bazolting71-arch/Drone-Payload-Hook-V2/docs/images/box_v23_hm10.png

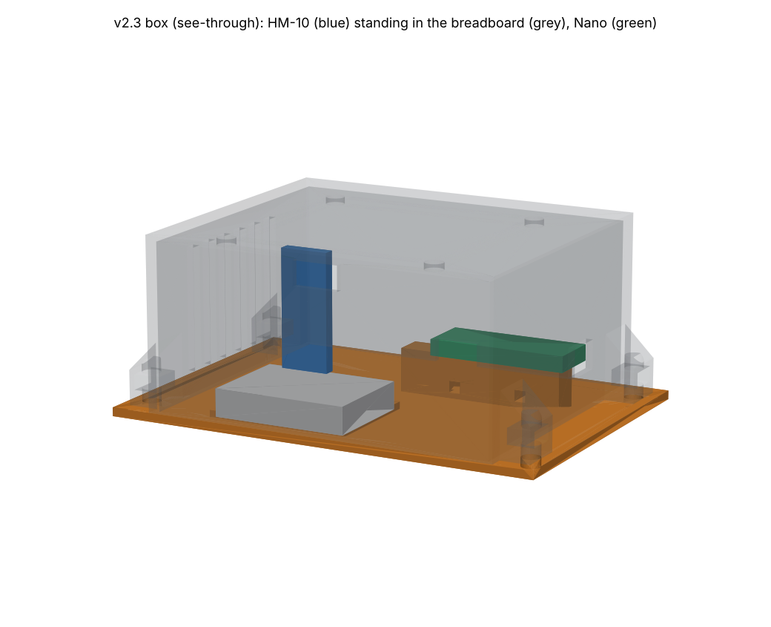
docs/images/box_v23_hm10.png
