bazolting71-arch/Drone-Payload-Hook-V2/docs/images/hook_rod_before_after.png

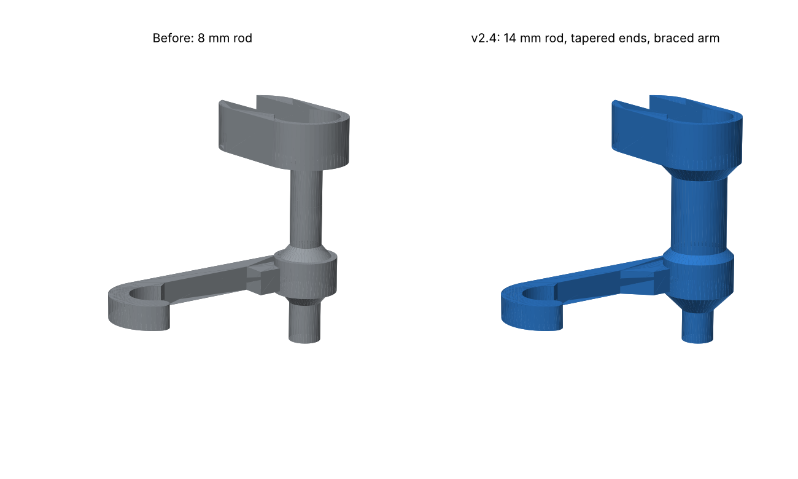
docs/images/hook_rod_before_after.png
