bazolting71-arch/Drone-Payload-Hook-V2/docs/images/servo_fasteners_v22.png

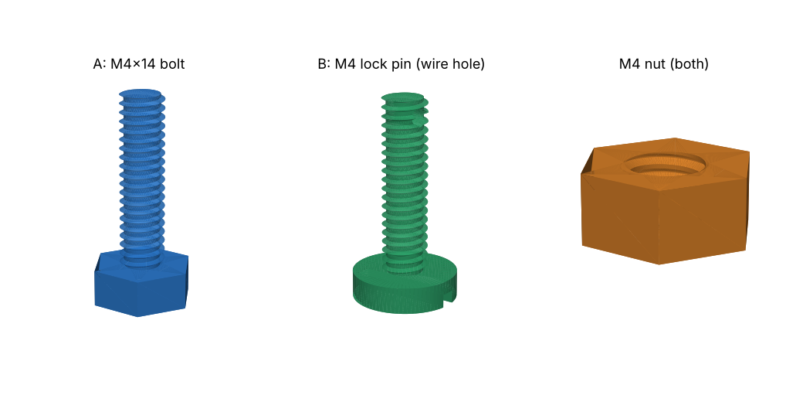
docs/images/servo_fasteners_v22.png
