bazolting71-arch/Drone-Payload-Hook-V2/cad/Thingy_Hook_Mount_v2.5.step

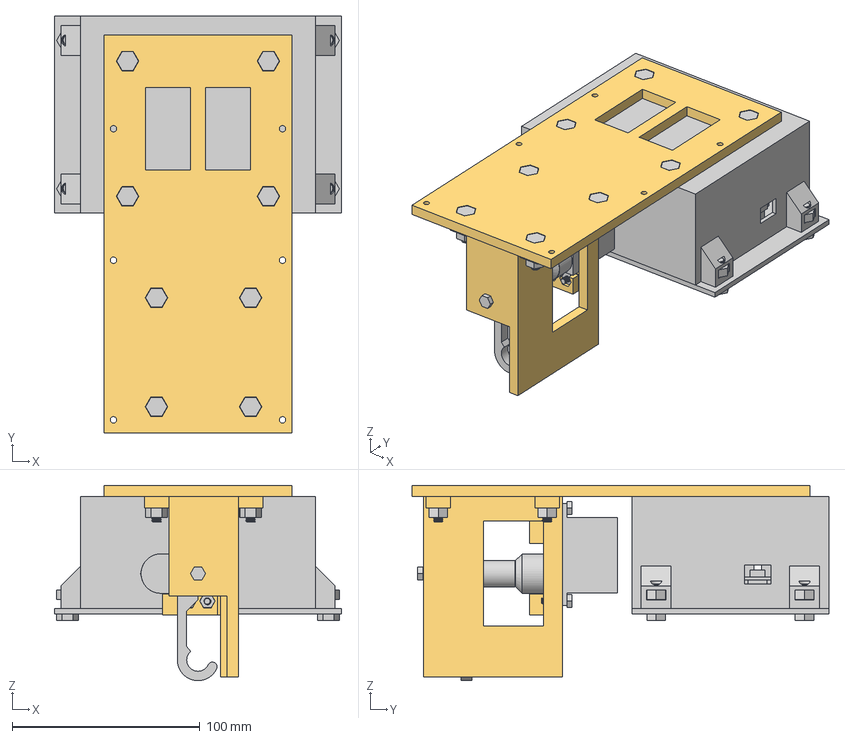
[picture p6: CAD file, 2026-11-05]
cad/Thingy_Hook_Mount_v2.5.step
153.0 x 222.0 x 104.0 mm
