bazolting71-arch/Drone-Payload-Hook-V2/stl/3_Thingy_v3_Hook_v2.5_tight_fit.stl

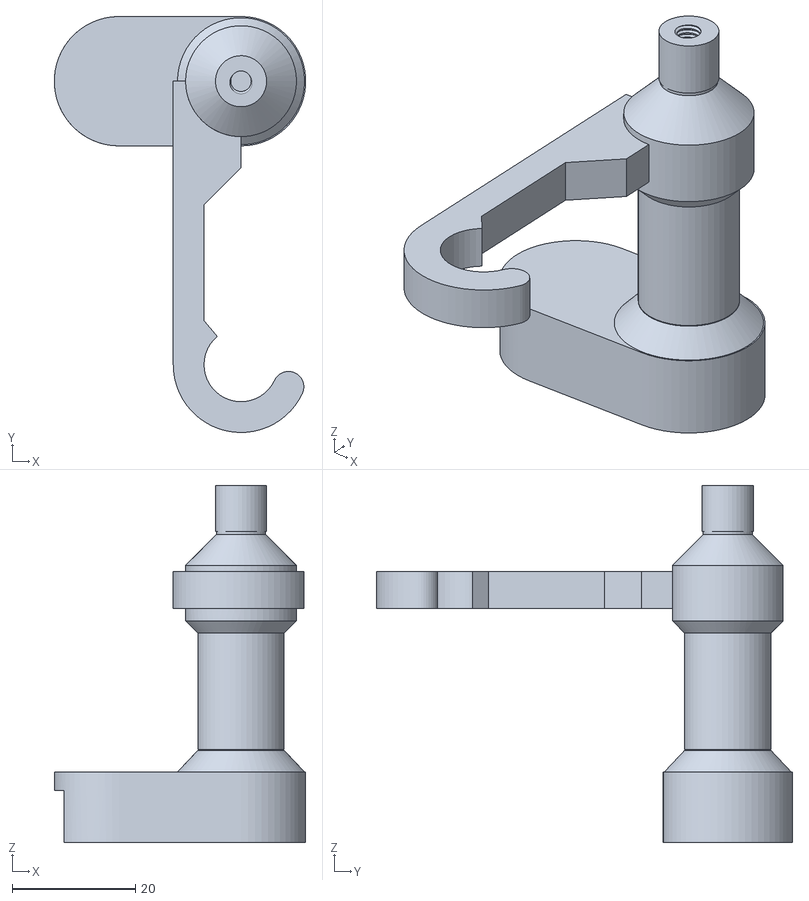
[picture p7: CAD file, 2026-11-05]
stl/3_Thingy_v3_Hook_v2.5_tight_fit.stl
40.8 x 67.5 x 58.0
