bazolting71-arch/Drone-Payload-Hook-V2/stl/9B_M4_Servo_Lock_Pin_print_x4.stl

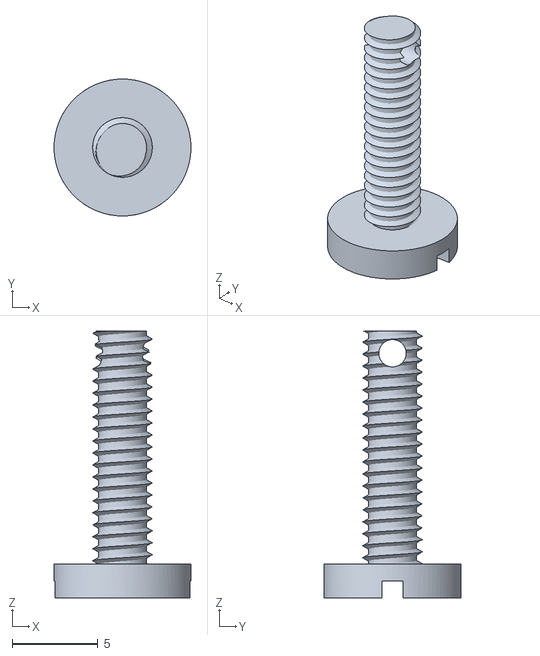
[picture p8: CAD file, 2026-11-05]
stl/9B_M4_Servo_Lock_Pin_print_x4.stl
8.00 x 8.00 x 15.6
