bazolting71-arch/Drone-Payload-Hook-V2/stl/1_Top_Plate.stl

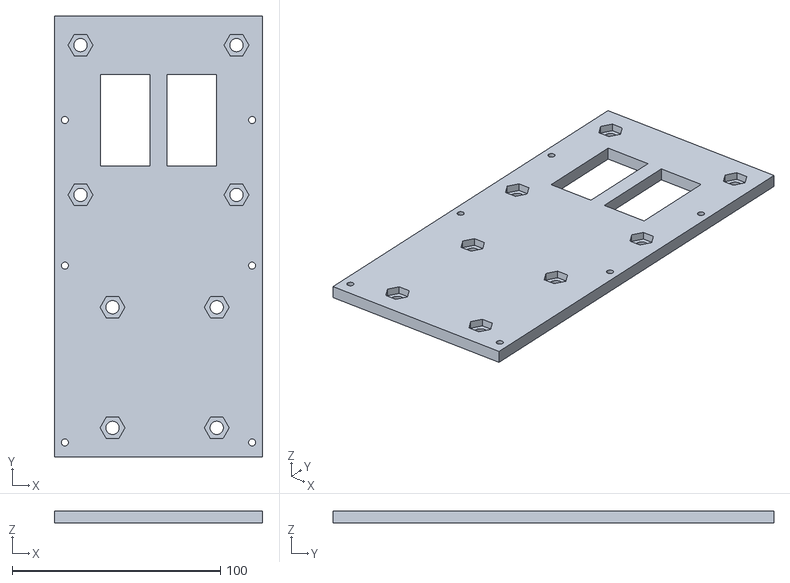
[picture p9: CAD file, 2026-11-05]
stl/1_Top_Plate.stl
100.0 x 212.0 x 6.00
