bazolting71-arch/Drone-Payload-Hook-V2/stl/10_Hook_Retainer_Sleeve_print_x1.stl

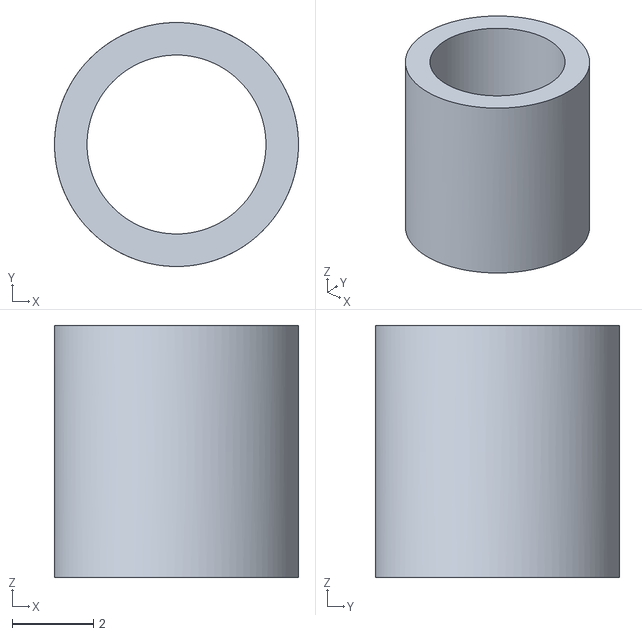
[picture p10: CAD file, 2026-11-05]
stl/10_Hook_Retainer_Sleeve_print_x1.stl
6.00 x 6.00 x 6.20
