bazolting71-arch/Drone-Payload-Hook-V2/stl/4_Electronics_Box_v2.3_tall.stl

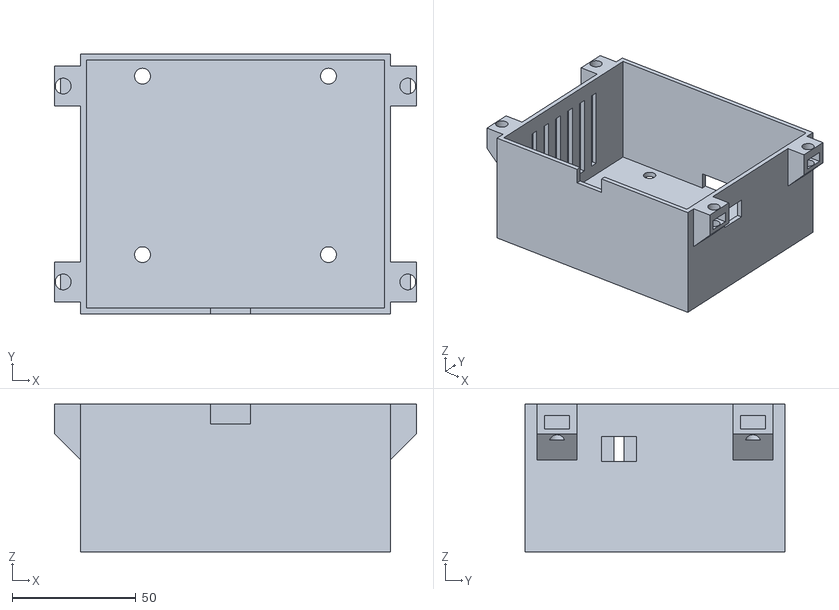
[picture p11: CAD file, 2026-11-05]
stl/4_Electronics_Box_v2.3_tall.stl
146.0 x 105.0 x 59.5
