bazolting71-arch/Drone-Payload-Hook-V2/stl/5_Electronics_Lid_Board_Tray_v2.3.stl

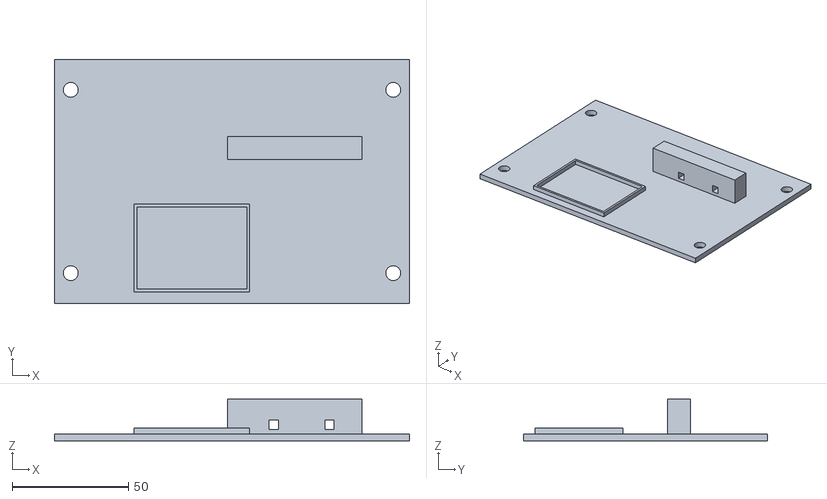
[picture p12: CAD file, 2026-11-05]
stl/5_Electronics_Lid_Board_Tray_v2.3.stl
153.0 x 105.0 x 18.0
