bazolting71-arch/Drone-Payload-Hook-V2/stl/2_Hook_Frame_v2.5.stl

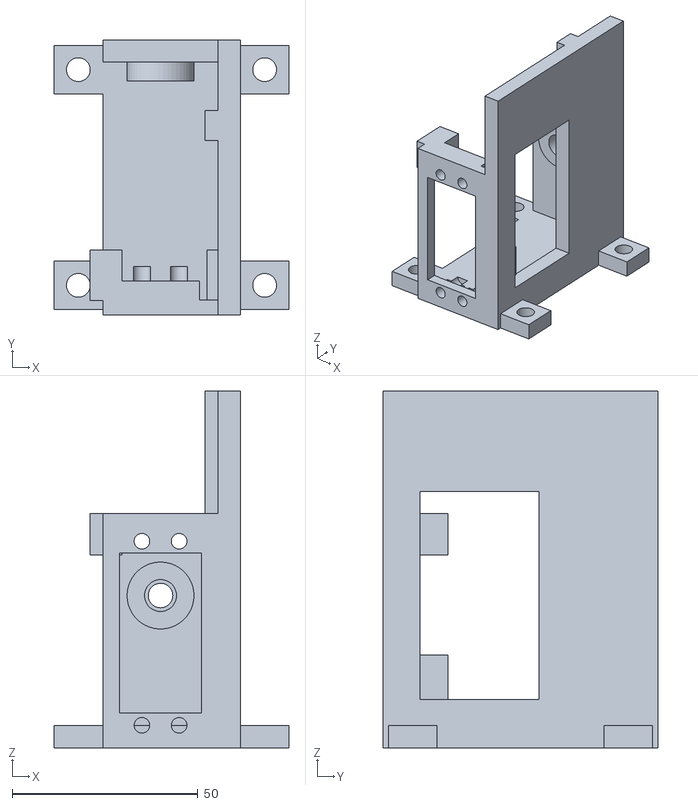
[picture p13: CAD file, 2026-11-05]
stl/2_Hook_Frame_v2.5.stl
63.1 x 74.0 x 96.0
