bazolting71-arch/Drone-Payload-Hook-V2/stl/8_Servo_Snap_Pin_print_x4.stl

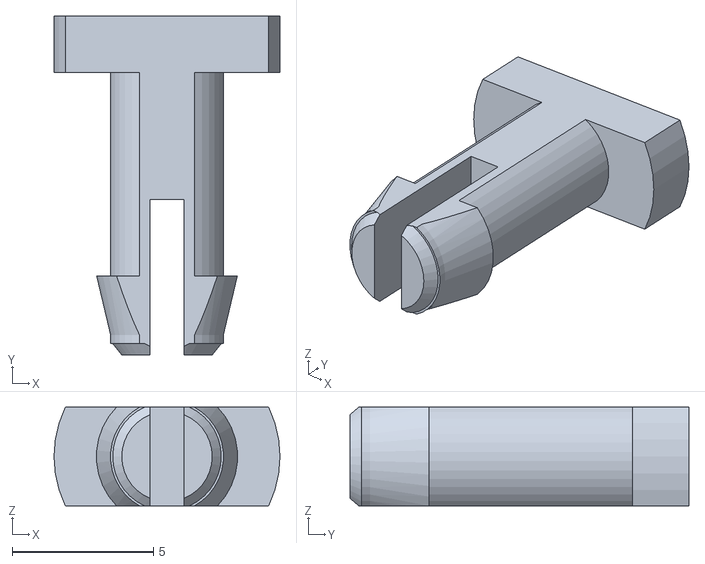
[picture p14: CAD file, 2026-11-05]
stl/8_Servo_Snap_Pin_print_x4.stl
8.00 x 12.0 x 3.50
