bazolting71-arch/Drone-Payload-Hook-V2/stl/6_M6x16_Bolt_print_x12.stl

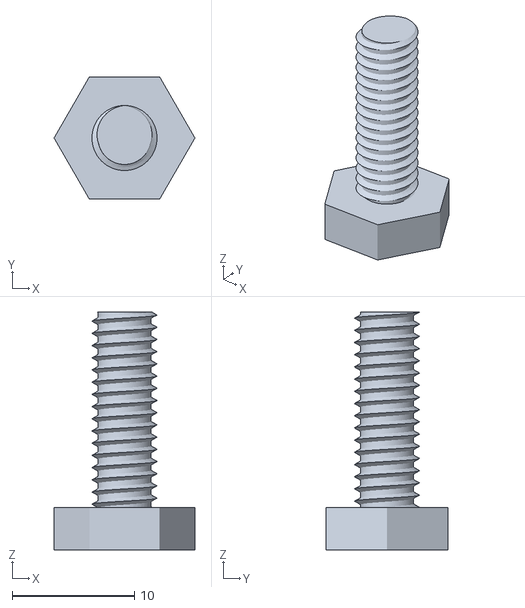
[picture p15: CAD file, 2026-11-05]
stl/6_M6x16_Bolt_print_x12.stl
11.5 x 10.0 x 19.5
