bazolting71-arch/Drone-Payload-Hook-V2/stl/9_M4_Servo_Nut_print_x4.stl

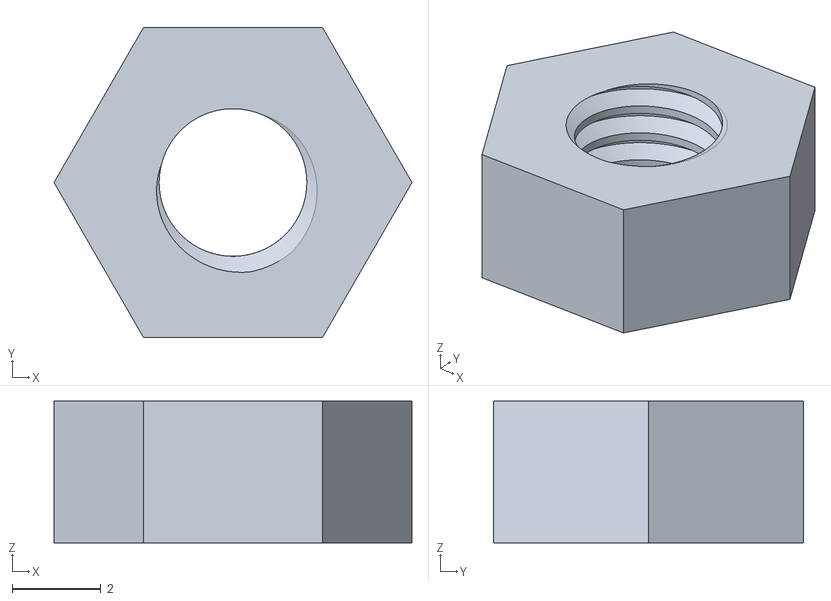
[picture p16: CAD file, 2026-11-05]
stl/9_M4_Servo_Nut_print_x4.stl
8.08 x 7.00 x 3.20
