bazolting71-arch/Drone-Payload-Hook-V2/stl/7_M6_Nut_print_x12.stl

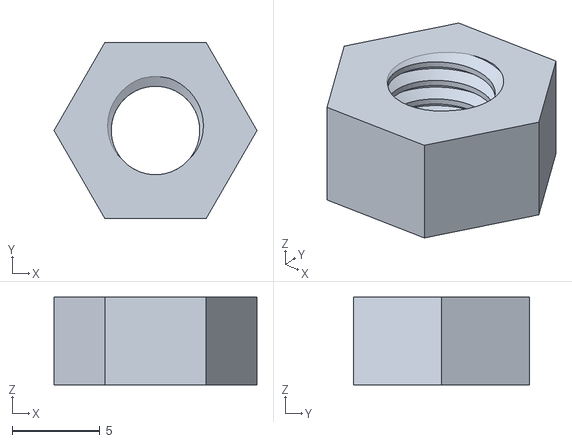
[picture p17: CAD file, 2026-11-05]
stl/7_M6_Nut_print_x12.stl
11.5 x 10.0 x 5.00
