bazolting71-arch/Drone-Payload-Hook-V2/stl/9A_M4x14_Servo_Bolt_print_x4.stl

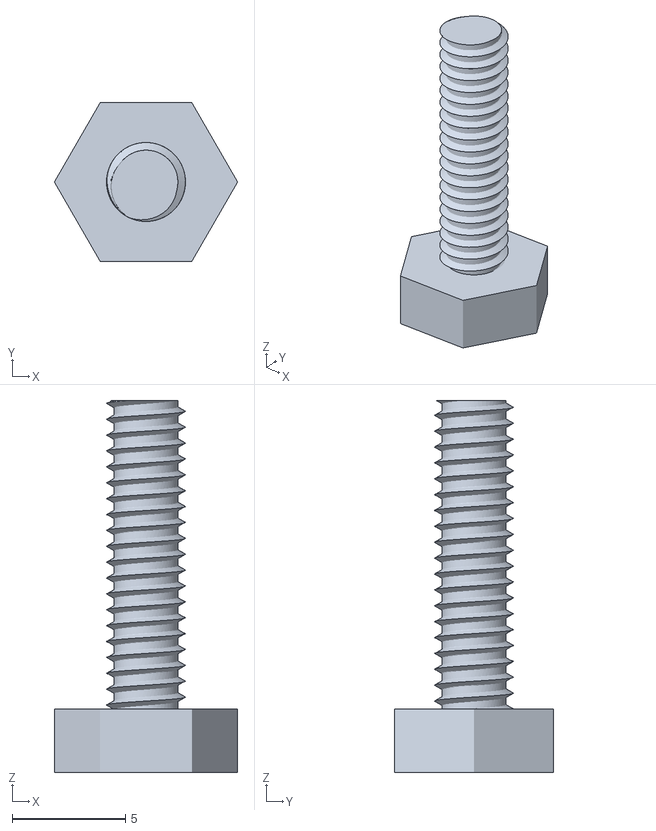
[picture p18: CAD file, 2026-11-05]
stl/9A_M4x14_Servo_Bolt_print_x4.stl
8.08 x 7.00 x 16.4
