bazolting71-arch/Drone-Payload-Hook-V2/(list of files, cad)

Other CAD files:
cad/Thingy_Hook_Mount_v2.5.f3d
